Jashdhokiya/miniOsci/oscilloscope_documentation (1).pdf

# STM32F411 Mini Oscilloscope

## with Integrated PWM Function Generator

### Technical Documentation

Firmware Source Code Reference – v1.0

Platform: STM32F411CEU6 (BlackPill) Display: ILI9341 2.8” TFT (SPI) IDE: STM32CubeIDE HAL: STM32F4xx HAL Language: C (ISO C99)
Year: 2026

Project Team

Jash Dhokiya | 23BIT058
Kavisha Sharma | 23BIT067
Dhyeya Choksi | 23BIT055
Tanay Shah | 23BIT062

Pandit Deendayal Energy University Department of ICT / ECE
Embedded Systems Laboratory

Copyright © 2026. Generated documentation. All rights reserved.

## Contents

1 Introduction | 3
2 Hardware Configuration | 5
3 Firmware Architecture | 8
4 Module Reference | 10

STM32F411 Mini Oscilloscope – Technical Documentation | CONTENTS
5 Data Flow and Timing | 16
6 Configuration Reference | 17
7 Build and Flash Instructions | 18
8 Limitations and Future Work | 19
A Interrupt Vector Summary | 20
B Colour Palette | 21
C Glossary | 22

## 1. Introduction

### 1.1 Project Overview

This project implements a dual-channel digital oscilloscope combined with a multi-waveform PWM function generator, running entirely on an STM32F411CEU6 (BlackPill) microcontroller. The system samples two analog input channels using the on-chip 12-bit ADC with DMA, displays real-time waveforms on an ILI9341 TFT LCD over SPI, computes signal parameters (frequency and Vpp), and simultaneously produces a user-selectable waveform on GPIO pin PB8 via PWM with an external RC low-pass filter.
The firmware is structured into well-separated modules: HAL-generated peripheral drivers (ADC, DMA, SPI, TIM, GPIO, USART), and custom application layers for ADC management, signal processing, display rendering, UI/button handling, and function generation.

### 1.2 Feature Summary

Core Features

| Dual-channel ADC input: CH1 (PA0) and CH2 (PA1), 12-bit resolution,
| timer-triggered via TIM2
| DMA transfer: Circular mode on DMA2 Stream 0 – zero CPU overhead for
| sampling
| Configurable time base: Multiple time/division settings via TIM2 auto-
| reload register
| Signal measurements: Real-time frequency (zero-crossing method) and Vpp
| ILI9341 display: Waveform, grid, measurements, and status bar over SPI1
Trigger system: Rising-edge trigger search per acquired buffer
| RUN / HOLD mode: Toggle via push-button (PB0)
| Overall stats overlay: Comprehensive signal statistics (freq, Vpp, Vmin, Vmax,
| Vavg) via push-button (PB4)
| Function generator: Sine, square, triangle, sawtooth – LUT-based PWM
| on PB8 (TIM4 CH3)
Analog watchdog: ADC overvoltage protection (threshold = 3700/4095)

### 1.3 Repository File Map

STM32F411 Mini Oscilloscope – Technical Documentation CHAPTER 1. INTRODUCTION

File | Category | Responsibility
main.c | Application | System init, splash screen, main loop
adc.c | HAL/Peripheral | ADC1 configuration, DMA linkage, GPIO
| | analog pins
dma.c | HAL/Peripheral | DMA2 clock enable, interrupt priority
spi.c | HAL/Peripheral | SPI1 master config for ILI9341
tim.c | HAL/Peripheral | TIM2 (ADC trigger), TIM3 (input capture),
| | TIM4 (PWM), TIM5 (FG step)
gpio.c | HAL/Peripheral | Output pins, button EXTI lines
usart.c | HAL/Peripheral | USART1 (optional debug)
osc adc.c | Application | ADC start/stop, buffer de-interleave, DMA
| | callback
osc signal.c | Application | Frequency, Vpp, trigger, pixel mapping
osc display.c | Application | Grid, waveform, measurement bar rendering
osc ui.c | Application | Button debounce, state machine, index
| | cycling
func gen.c | Application | LUT tables, TIM4/TIM5 PWM function
| | generator
stm32f4xx it.c | ISR | All ISR vectors, EXTI/TIM5/DMA/ADC
| | callbacks
stm32f4xx hal msp.cHAL/Peripheral | MSP init/deinit callbacks
syscalls.c | System | Newlib syscall stubs
sysmem.c | System | Heap memory implementation
system stm32f4xx.c CMSIS | SystemClock and SystemCoreClock init

## 2. Hardware Configuration

### 2.1 Microcontroller

The STM32F411CEU6 (BlackPill) is a Cortex-M4F running at up to 100 MHz. In this project the PLL is configured to deliver exactly 100 MHz system clock from a 25 MHz HSE crystal, enabling deterministic sample rate calculations.

### 2.1.1 System Clock Configuration

1 | RCC_OscInitStruct . OscillatorType = RCC_OSCILLATORTYPE_HSE ;
2 | RCC_OscInitStruct . HSEState | = RCC_HSE_ON ;
3 | RCC_OscInitStruct . PLL . PLLState | = RCC_PLL_ON ;
4 | RCC_OscInitStruct . PLL . PLLSource | = RCC_PLLSOURCE_HSE ;
5 | RCC_OscInitStruct . PLL . PLLM | = 25; | /* divide 25 MHz -> 1 MHz */
6 | RCC_OscInitStruct . PLL . PLLN | = 200; | /* x200 -> 200 MHz VCO | */
7 | RCC_OscInitStruct . PLL . PLLP | = RCC_PLLP_DIV2 ; | /* /2 -> 100 MHz */
8 | RCC_OscInitStruct . PLL . PLLQ | = 4;

Listing 2.1: PLL configuration in SystemClock Config()

fSY SCLK =

fHSE × N
M × P

=

25 × 200
25 × 2

= 100 MHz

### 2.1.2 Bus Clocks

Bus | Divider Frequency
SYSCLK | 1 | 100 MHz
HCLK (AHB) | 1 | 100 MHz
PCLK1 (APB1) 2 | 50 MHz
PCLK2 (APB2) 1 | 100 MHz

Flash Latency

Flash latency is set to FLASH LATENCY 3 (3 wait states) as required for 100 MHz Vcore Scale 1.

### 2.2 GPIO Pin Assignments

STM32F411 Mini Oscilloscope – Technical Documentation CHAPTER 2. HARDWARE CONFIGURATION

Port | Pin | Function | Description
PA0 | – | ADC1 IN0 | Channel 1 analog input
PA1 | – | ADC1 IN1 | Channel 2 analog input
PA3 | – | GPIO Output | ILI9341 DC (Data/Command)
PA4 | – | GPIO Output | ILI9341 CS (Chip Select)
PA5 | – | SPI1 SCK | ILI9341 SPI clock
PA6 | – | TIM3 CH1 | Input capture (reserved/debug)
PA7 | – | SPI1 MOSI | ILI9341 SPI data
PB0 | – | EXTI0 (rising) | Button: RUN/HOLD toggle
PB1 | – | EXTI1 (rising) | Button: Time div cycle
PB2 | – | EXTI2 (rising) | Button: Volt div cycle
PB3 | – | EXTI3 (rising) | Button: Channel toggle
PB4 | – | EXTI4 (rising) | Button: Show overall signal statistics
PB6 | – | GPIO Output | ILI9341 RST
PB7 | – | GPIO Output | ILI9341 LED backlight
PB8 | – | TIM4 CH3 | Function generator PWM output

### 2.3 ADC Configuration

ADC1 is configured in adc.c with the following parameters:

Parameter | Value
Resolution | 12-bit
Clock prescaler | PCLK2 / 4 = 25 MHz ADC clock
Scan mode | Enabled (2 channels)
Conversion mode Discontinuous (timer-triggered)
External trigger | TIM2 TRGO (rising edge)
DMA mode | Circular, half-word
Analog watchdog All regular channels, High = 3700

Both channels are ranked in sequence (Rank 1 = CH0/PA0, Rank 2 = CH1/PA1), with 15 ADC clock cycle sampling time each. The interleaved raw buffer layout is:

adcRawBuffer = [CH1
| | | {z }
0
| | | , CH2 | {z }
| | | 1 , CH1 | {z }
| | | 2 , CH2 | {z }
| | | 3 , . . .]

STM32F411 Mini Oscilloscope – Technical Documentation CHAPTER 2. HARDWARE CONFIGURATION

### 2.4 Timer Summary

Timer | Mode | Period | Purpose
TIM2 | Base +
| TRGO | Runtime
| | variable
(ARR)
| | | ADC sample rate trigger; ARR =
| | | 100 MHz
| | | fs − 1
TIM3 | Input
| Capture | 65535 | CH1 on PA6 (reserved for HW
| | | frequency measurement)
TIM4 | PWM CH3 | FUNCGEN PWM High-frequency carrier for function ARR
| | | generator
TIM5 | Base + IT | fclk
| | fout×64 − 1 | LUT step interrupt for function
| | | generator

## 3. Firmware Architecture

### 3.1 Layer Overview

The firmware follows a layered architecture separating HAL-generated peripheral code

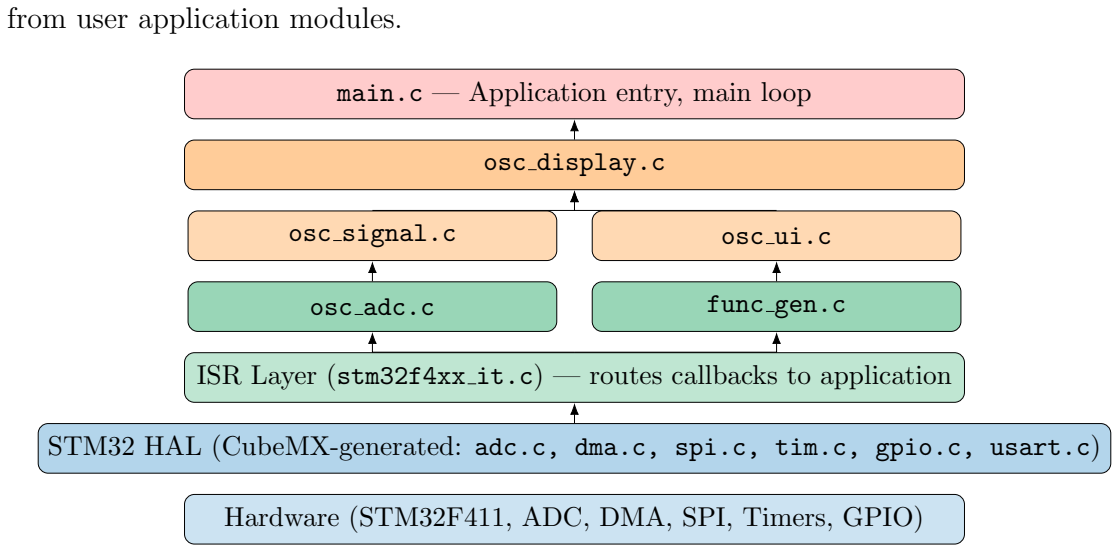
[picture p3: figure]
from user application modules.; osc adc.c; func gen.c; osc signal.c; osc ui.c; osc display.c; main.c — Application entry, main loop

Hardware (STM32F411, ADC, DMA, SPI, Timers, GPIO)

STM32 HAL (CubeMX-generated: adc.c, dma.c, spi.c, tim.c, gpio.c, usart.c)

ISR Layer (stm32f4xx it.c) — routes callbacks to application

### 3.2 Main Loop Logic

After peripheral initialization and the splash screen, main() enters an infinite loop that polls a volatile flag bufferReady (set by the DMA completion ISR) and the UI state machine:

1 | while (1) {
2 | if ( bufferReady && UI_GetState () == STATE_RUN ) {
3 | bufferReady = 0;
4 | uint16_t * buf = OSC_ADC_GetBuffer ( UI_GetChannel () ) ;
5 | float freq = Signal_GetFrequency ( buf , SAMPLE_BUFFER_SIZE ,
| sampleRate ) ;
6 | float vpp | = Signal_GetVpp ( buf , SAMPLE_BUFFER_SIZE ) ;

7
8 | Display_ClearWaveform () ;
9 | Display_DrawGrid () ;
10 | Display_DrawWaveform ( buf , SAMPLE_BUFFER_SIZE , channel , voltDiv ) ;
11 | Display_DrawMeasurements ( freq , vpp , channel , timeDivIdx ,
| voltDivIdx , 0) ;
12 | }
13 | else if ( UI_GetState () == STATE_HOLD ) {

STM32F411 Mini Oscilloscope – Technical Documentation CHAPTER 3. FIRMWARE ARCHITECTURE

14 | /* Redraw measurements once with HOLD label */
15 | }
16 | }

Listing 3.1: Main application loop (simplified from main.c)

Design Note

The main loop is interrupt-driven – it never polls the ADC directly. All sampling is triggered by TIM2 → ADC → DMA. The CPU is only involved when bufferReady = 1 is set from the DMA ISR, making it quasi-event-driven without an RTOS.

### 3.3 Interrupt Priority Table

Interrupt | Preempt | Sub | Function
DMA2 Stream0 | 0 | 0 | ADC DMA transfer
| | | complete
ADC (analog watchdog) | 0 | 0 | Overvoltage stop
TIM5 | 2 | 0 | Function generator LUT
| | | step
EXTI0–EXTI3 | 3 | 0 | Button press handling

## 4. Module Reference

### 4.1 osc adc.c — ADC Application Layer

### 4.1.1 Purpose

Wraps the CubeMX-generated hadc1 and htim2 handles into a clean start/stop API and exposes per-channel sample buffers. It also performs de-interleaving of the raw DMA buffer.

### 4.1.2 Buffers

1 | static uint16_t adcRawBuffer [ ADC_BUFFER_SIZE ]; /* interleaved CH1 ,CH2
| ,... */
2 | static uint16_t ch1Buffer [ SAMPLE_BUFFER_SIZE ];
3 | static uint16_t ch2Buffer [ SAMPLE_BUFFER_SIZE ];
4 | volatile uint8_t bufferReady = 0;

Listing 4.1: Buffer declarations in osc adc.c

ADC BUFFER SIZE = 2 × SAMPLE BUFFER SIZE to hold both channels interleaved.

### 4.1.3 API

Function | Returns | Description
OSC ADC Start() | void | Starts ADC DMA + TIM2
OSC ADC Stop() | void | Stops TIM2 + ADC DMA
OSC ADC GetBuffer(ch) | uint16 t* | Returns pointer to de-interleaved
| | channel buffer
OSC ADC SetSampleRate(arr) void | Dynamically updates TIM2 ARR

### 4.1.4 De-interleave Algorithm

1 | static void DeInterleave ( void ) {
2 | for ( uint16_t i = 0; i < SAMPLE_BUFFER_SIZE ; i ++) {
3 | ch1Buffer [ i ] = adcRawBuffer [ i * 2];
4 | ch2Buffer [ i ] = adcRawBuffer [ i * 2 + 1];
5 | }
6 | }

Listing 4.2: De-interleave routine

STM32F411 Mini Oscilloscope – Technical Documentation CHAPTER 4. MODULE REFERENCE

### 4.1.5 Callbacks

HAL ADC ConvCpltCallback Called by the DMA ISR when the full buffer is transferred. Sets bufferReady = 1.

HAL ADC LevelOutOfWindowCallback Called by the ADC analog watchdog ISR when input exceeds 3700/4095 (≈ 3.0 V). Calls OSC ADC Stop() to protect inputs.

### 4.2 osc signal.c — Signal Processing

### 4.2.1 Purpose

Pure computation module. Takes raw 12-bit ADC buffers and returns physical measurements. No HAL calls.

### 4.2.2 Function Reference

Function | Returns | Description
Signal GetFrequency(buf, size, sr) | float | Frequency via rising zero-crossing
| | count
Signal GetVpp(buf, size) | float | Peak-to-peak voltage in volts
Signal GetVmin(buf, size) | float | Minimum voltage
Signal GetVmax(buf, size) | float | Maximum voltage
Signal GetAvg(buf, size) | float | DC average voltage
Signal FindTriggerPoint(buf,
size, thresh) | uint16 t | Index of first rising edge crossing
| | thresh
Signal MapToPixel(adcVal, voltDiv) | uint16 t | Maps ADC code to display Y pixel

### 4.2.3 Frequency Measurement Algorithm

The frequency is estimated from the number of rising zero-crossings across the buffer. The midpoint threshold is auto-computed from Vmin and Vmax:

1 | uint16_t midpoint = ( vMin + vMax ) / 2;
2 | if (( vMax - vMin ) < 50) return 0.0 f ; | /* signal too weak */

3
4 | for ( uint16_t i = 1; i < size ; i ++) {
5 | if ( buffer [i -1] < midpoint && buffer [ i ] >= midpoint ) {
6 | crossingCount ++;
7 | if ( crossingCount == 1) firstCrossing = i ;
8 | lastCrossing = i ;
9 | }
10 | }
11 | float samplesPerPeriod = ( lastCrossing - firstCrossing ) / ( crossingCount
- 1) ;
12 return ( float ) sampleRate / samplesPerPeriod ;

Listing 4.3: Zero-crossing frequency algorithm

STM32F411 Mini Oscilloscope – Technical Documentation CHAPTER 4. MODULE REFERENCE

### 4.2.4 Voltage Conversion

Vpp =

ADCmax − ADCmin
4095

× VREF × Rdiv

where VREF = 3.3 V and Rdiv is the input voltage divider ratio defined in config.h.

### 4.2.5 Pixel Mapping

ypixel = ycenter −

ADCval − 2048

ADCper div
×

Hwave

Vdivs

Clamped to [W AV E Y OF F SET, W AV E Y OF F SET + W AV E HEIGHT − 1].

### 4.3 osc display.c — Display Rendering

### 4.3.1 Purpose

Manages all ILI9341 rendering: initialization, grid drawing, waveform plotting with vertical line interpolation between samples, and the top/bottom HUD bars.

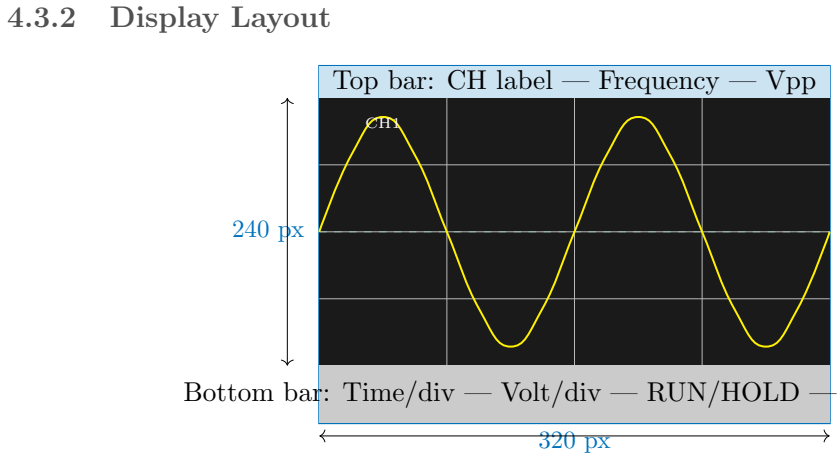
[picture p4: figure]
4.3.2 Display Layout; Top bar: CH label — Frequency — Vpp

Bottom bar: Time/div — Volt/div — RUN/HOLD — FG status

Figure 4.1: ILI9341 display layout (320×240 pixels)

### 4.3.3 API

Function | Returns | Description
Display Init() | void | Init ILI9341, fill black, reset
| | prev-wave state
Display ClearScreen() | void | Fill entire screen black
Display ClearWaveform() | void | Clear waveform region only
Display DrawGrid() | void | Dotted grid + dashed centre
| | axes
Display DrawWaveform(buf,sz,ch,vd) void | Trigger-aligned waveform with
| | line interpolation
Display DrawMeasurements(...) void | Top bar (freq, Vpp), bottom
| | bar (T/div, V/div, mode, FG)

STM32F411 Mini Oscilloscope – Technical Documentation CHAPTER 4. MODULE REFERENCE

Function | Returns | Description
Display ShowWarning(msg) | void | Centred red warning overlay box

### 4.3.4 Waveform Rendering Detail

The waveform is rendered starting from the trigger point (first rising edge). For each sample pair (i−1, i), a pixel and a connecting line are drawn to avoid gaps at low time/div settings:

1 | ILI9341_DrawPixel (x , y , waveColor ) ;
2 | if ( i > 0)
3 | ILI9341_DrawLine ( WAVE_X_OFFSET + i - 1 , prevY , x , y , waveColor ) ;

Listing 4.4: Line interpolation in waveform rendering

### 4.4 osc ui.c — User Interface State Machine

### 4.4.1 State Machine

STATE RUN | STATE HOLD

PB0 pressed

PB0 pressed

PB1/PB2/PB3: div & ch; PB4: stats overlay

Figure 4.2: UI state machine

### 4.4.2 Button Mapping

GPIO Pin | EXTI | Action
PB0 | EXTI0 | Toggle RUN ↔ HOLD; also stops/restarts ADC
PB1 | EXTI1 Cycle time/div index (0 → NUM TIME DIVS −1) + update TIM2 ARR
PB2 | EXTI2 | Cycle volt/div index (0 → NUM VOLT DIVS −1)
PB3 | EXTI3 | Toggle active channel (CH1 ↔ CH2)
PB4 | EXTI4 | Display overall signal statistics overlay (freq, Vpp, Vmin, Vmax, Vavg)

### 4.4.3 Debounce

Software debounce of BUTTON DEBOUNCE MS milliseconds is applied using HAL GetTick() at the start of UI HandleButton().

### 4.5 func gen.c — PWM Function Generator

STM32F411 Mini Oscilloscope – Technical Documentation CHAPTER 4. MODULE REFERENCE

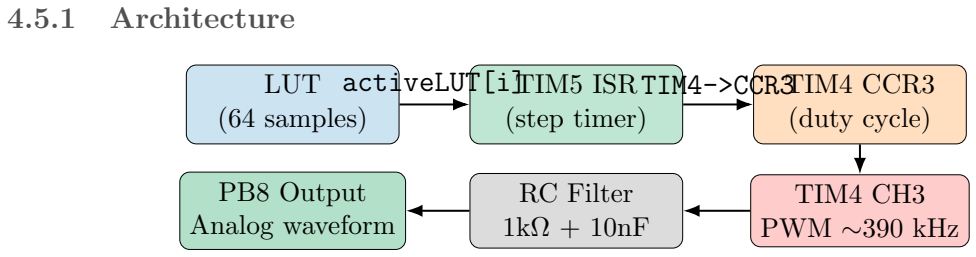
[picture p5: figure]
4.5.1 Architecture; LUT (64 samples); TIM5 ISR (step timer); TIM4 CCR3 (duty cycle); TIM4 CH3 PWM ∼390 kHz; RC Filter 1kΩ + 10nF; PB8 Output Analog waveform; activeLUT[i]; TIM4->CCR3

Figure 4.3: Function generator signal chain

### 4.5.2 Waveform LUTs

Four 64-sample lookup tables are stored in static const uint8 t arrays (values 0–255):

Waveform Table | Description
Sine | sineLUT[64] | Full-period sinusoid
Square | squareLUT[64] | 50% duty, 255 for first 32 samples, 0 for last 32
Triangle | triangleLUT[64] Linear ramp up + down
Sawtooth | sawtoothLUT[64] Linear ramp 0 → 255

### 4.5.3 Frequency Formula

TIM5 auto-reload register (ARR) controls the step rate:

ARRT IM5 =

fclk

fout × NLUT

− 1 =

100 MHz

fout × 64

− 1

fPWMcarrier ≈

fclk
ARRT IM4 + 1

≈ 390 kHz

The RC filter cut-off frequency is:

fc =

1
2πRC =

1
2π × 1000 × 10 × 10⁻⁹

≈ 15.9 kHz

### 4.5.4 ISR – FuncGen StepISR()

Called directly from TIM5 IRQHandler (using raw register access to minimise latency):

1 | void FuncGen_StepISR ( void ) {
2 | TIM4 - > CCR3 = activeLUT [ lutIndex ];
3 | lutIndex = ( lutIndex + 1) & ( FUNCGEN_LUT_SIZE - 1) ;
4 | }

Listing 4.5: LUT step ISR (latency-critical)

The bitmask & 63 wraps the index without a branch.

### 4.5.5 API

STM32F411 Mini Oscilloscope – Technical Documentation CHAPTER 4. MODULE REFERENCE

Function | Returns | Description
FuncGen Init() | void | Sets defaults (sine, 1 kHz), resets
| | state
FuncGen Start() | void | Starts TIM4 PWM + TIM5 step
| | timer
FuncGen Stop() | void | Stops TIM5, zeros duty, stops TIM4
FuncGen SetWaveform(type) | void | Switches active LUT pointer
FuncGen SetFrequency(Hz) | void | Updates TIM5 ARR dynamically
FuncGen IsRunning() | uint8 t | Returns running flag
FuncGen GetFrequency() | uint32 t | Returns current set frequency
FuncGen GetWaveformName() | const
| char* | Returns “SIN”, “SQR”, “TRI”,
| | “SAW”

### 4.6 stm32f4xx it.c — Interrupt Service Routines

### 4.6.1 ISR Routing Table

ISR | Action
SysTick Handler | HAL IncTick() – millisecond tick for HAL
timeouts and debounce
DMA2 Stream0 IRQHandler HAL DMA IRQHandler() → triggers
HAL ADC ConvCpltCallback
ADC IRQHandler | HAL ADC IRQHandler() → analog watchdog
callback
EXTI0...3 IRQHandler HAL GPIO EXTI IRQHandler() →
UI HandleButton(pin)
TIM5 IRQHandler | Direct register: clears UIF, calls
FuncGen StepISR()
HardFault Handler | Infinite loop (breakpoint target)

Why TIM5 bypasses HAL

TIM5 IRQHandler directly clears TIM5->SR and calls FuncGen StepISR() without going through HAL TIM IRQHandler(). This avoids ∼20 HAL overhead instructions, which matters at high function generator frequencies where TIM5 fires at up to fout × 64 times per second.

## 5. Data Flow and Timing

### 5.1 Oscilloscope Data Flow

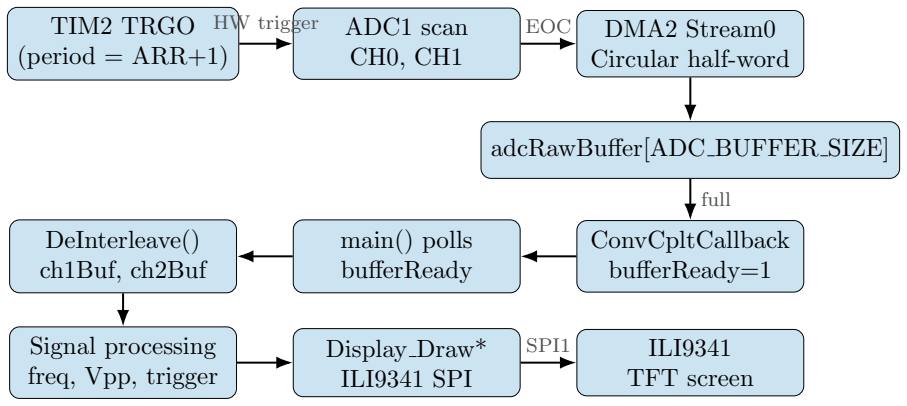
[picture p6: figure]
TIM2 TRGO (period = ARR+1); ADC1 scan CH0, CH1; DMA2 Stream0 Circular half-word; adcRawBuffer[ADC BUFFER SIZE]; ConvCpltCallback bufferReady=1; main() polls bufferReady; DeInterleave() ch1Buf, ch2Buf; Signal processing freq, Vpp, trigger; Display Draw* ILI9341 SPI; ILI9341 TFT screen; HW trigger; EOC; full; SPI1

Figure 5.1: End-to-end oscilloscope data flow

### 5.2 Sample Rate Calculation

TIM2 runs on APB1 ×2 = 100 MHz. The sample rate in samples per second per channel is:

fs =

100 MHz
(ARR + 1) × 2

The factor of 2 accounts for two channels being scanned per TIM2 trigger. The TIME DIV ARR[] lookup table in config.h maps time/div settings to the correct ARR value.

### 5.3 Function Generator Timing

TIM5 fires at fstep = fout × 64. At the default frequency of 1 kHz:

ARRT IM5 =

100 MHz
1000 × 64

− 1 = 1562 − 1 = 1561

The PWM carrier on TIM4 at ≈ 390 kHz combined with the 15.9 kHz RC filter produces a smooth analog approximation of the selected waveform.

## 6. Configuration Reference

All project-wide constants are consolidated in config.h. Key parameters:

Macro | Typical Value | Description
SAMPLE BUFFER SIZE | 512 | Samples per channel per
| | acquisition
ADC BUFFER SIZE | 1024 | Raw DMA buffer (2× above)
ADC MAX | 4095 | 12-bit full-scale
VREF | 3.3f | ADC reference voltage (V)
VOLTAGE DIVIDER RATIO | ≥1.0 | Input resistor divider scale
SCREEN WIDTH | 320 | ILI9341 pixel width
SCREEN HEIGHT | 240 | ILI9341 pixel height
WAVE X OFFSET | – | Left edge of waveform area
WAVE Y OFFSET | – | Top edge of waveform area
WAVE WIDTH | – | Waveform area width
WAVE HEIGHT | – | Waveform area height
GRID DIVISIONS X | 8 | Horizontal grid divisions
GRID DIVISIONS Y | 6 | Vertical grid divisions
NUM TIME DIVS | – | Length of time-div array
NUM VOLT DIVS | – | Length of volt-div array
NUM CHANNELS | 2 | Oscilloscope channels
BUTTON DEBOUNCE MS | 50 | Button debounce time (ms)
FUNCGEN DEFAULT FREQ | 1000 | Default function gen frequency
(Hz)
FUNCGEN LUT SIZE | 64 | Samples per LUT waveform
| | period
FUNCGEN PWM ARR | ≈255 | TIM4 ARR for PWM carrier
FUNCGEN TIM CLOCK | 100000000 | TIM5 clock frequency (Hz)

## 7. Build and Flash Instructions

### 7.1 Prerequisites

| STM32CubeIDE ≥ 1.14 (includes arm-none-eabi-gcc)
| STM32F4xx HAL library (included in CubeIDE)
| ST-Link V2 programmer, or DFU via USB

### 7.2 Project Setup

1. Open STM32CubeIDE and import or create an STM32F411CE project.
2. In CubeMX (inside IDE), configure peripherals to match Chapter 2.
3. Copy all .c files from Src/ into the project’s Core/Src/ folder.
4. Ensure the following driver/library files are present (generated by CubeMX):
| Drivers/STM32F4xx HAL Driver/
| Drivers/CMSIS/
| Core/Inc/ headers: config.h, osc adc.h, osc signal.h,
osc display.h, osc ui.h, func gen.h, ili9341.h
5. Build with Release configuration for optimal performance.
6. Flash via Run → Debug or ST-LINK/V2 programmer.

### 7.3 Expected Boot Sequence

1. HAL, system clock, and all peripherals initialize.
2. Splash screen shown for 1.5 s: “OSCILLOSCOPE / Dual Channel / + Function Generator”.
3. Function generator starts (1 kHz sine on PB8).
4. ADC + DMA + TIM2 start.
5. Main loop begins: waveform acquisition and display.

## 8. Limitations and Future Work

### 8.1 Current Limitations

Known Issues

ADC analog watchdog: Stop on overvoltage does not display a warning in current code – Display ShowWarning() call is commented out in the callback.
| Frequency measurement: Zero-crossing algorithm is susceptible to noise
| on near-DC or irregular signals. No averaging is applied.
| Function generator amplitude: Fixed to 3.3 V swing (PWM × RC). No
| software amplitude control.
| No RTOS: Display latency under heavy SPI loads may cause missed ADC
| buffer cycles (frame dropping, not data loss).

### 8.2 Suggested Improvements

Enhancement Roadmap

Add UART serial output for waveform data export.
| Implement averaging for frequency and Vpp (running mean over N frames).
| Use TIM3 input capture for hardware frequency measurement crosscheck.
Add FreeRTOS task separation between acquisition and rendering.
Implement function generator amplitude control via DAC or digital pot.
Add waveform cursors (time-delta, voltage-delta measurement).
Support FFT spectrum display using CMSIS DSP library.

## A. Interrupt Vector Summary

Vector | Priority (Pre/Sub) Handler
DMA2 Stream0 IRQn | 0 / 0 | HAL DMA IRQHandler
ADC IRQn | 0 / 0 | HAL ADC IRQHandler
TIM5 IRQn | 2 / 0 | FuncGen StepISR (direct)
EXTI0 IRQn | 3 / 0 | UI HandleButton(PIN 0)
EXTI1 IRQn | 3 / 0 | UI HandleButton(PIN 1)
EXTI2 IRQn | 3 / 0 | UI HandleButton(PIN 2)
EXTI3 IRQn | 3 / 0 | UI HandleButton(PIN 3)
EXTI4 IRQn | 3 / 0 | UI HandleButton(PIN 4)
SysTick | – | HAL IncTick

## B. Colour Palette

The display uses the following colour definitions (RGB565 format expected by ILI9341 driver):

Macro | Usage
COLOR BACKGROUND | Screen fill (black)
COLOR GRID | Dotted grid lines
COLOR DARK GREEN | Centre axis lines
COLOR DARK GRAY | Waveform area border
COLOR CH1 | Channel 1 waveform (yellow)
COLOR CH2 | Channel 2 waveform (cyan)
COLOR GREEN | T/div label, RUN indicator
COLOR RED | HOLD indicator, warnings
COLOR ORANGE | Function generator status
COLOR TEXT | General measurement text
COLOR WHITE | Warning overlay text

## C. Glossary

ADC Analog-to-Digital Converter

ARR Auto-Reload Register (sets timer period)

CCR Capture/Compare Register (sets PWM duty cycle)

DMA Direct Memory Access

EXTI External Interrupt line

HAL Hardware Abstraction Layer (STM32 middleware)

HSE High-Speed External crystal oscillator

ILI9341 262K-colour TFT LCD controller by Ilitek

ISR Interrupt Service Routine

LUT Lookup Table

NVIC Nested Vectored Interrupt Controller

PLL Phase-Locked Loop (clock multiplier)

PWM Pulse-Width Modulation

RC filter Resistor-Capacitor low-pass filter

SPI Serial Peripheral Interface

TIM General-Purpose Timer (STM32)

TRGO Timer Trigger Output (used to trigger ADC)

Vpp Peak-to-peak voltage

VREF ADC reference voltage
