Jashdhokiya/miniOsci/Core/Src/main.c

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
/* Includes ------------------------------------------------------------------*/
#include "main.h"
#include "adc.h"
#include "dma.h"
#include "spi.h"
#include "tim.h"
#include "usart.h"
#include "gpio.h"

/* USER CODE BEGIN Includes */
#include "config.h"
#include "osc_adc.h"
#include "osc_signal.h"
#include "osc_display.h"
#include "osc_ui.h"
#include "ili9341.h"
#include "func_gen.h"
#include <string.h>
#include <stdio.h>
/* USER CODE END Includes */


/* USER CODE BEGIN PV */
static uint8_t holdDrawn = 0;
/* USER CODE END PV */

void SystemClock_Config(void);
/**
  * @brief  The application entry point.
  * @retval int
  */
int main(void)
{

  /* MCU Configuration--------------------------------------------------------*/

  /* Reset of all peripherals, Initializes the Flash interface and the Systick. */
  HAL_Init();

  /* Configure the system clock */
  SystemClock_Config();

  /* Initialize all configured peripherals */
  MX_GPIO_Init();
  MX_DMA_Init();
  MX_ADC1_Init();
  MX_SPI1_Init();
  MX_TIM2_Init();
  MX_TIM3_Init();
  MX_USART1_UART_Init();
  MX_TIM4_Init();
  MX_TIM5_Init();
  /* USER CODE BEGIN 2 */

  /* Initialize display */
  Display_Init();

  /* Splash screen — landscape centered */
  ILI9341_FillScreen(COLOR_PANEL_BG);
  ILI9341_DrawString(64, 60, "MINI OSCILLOSCOPE", COLOR_GREEN, COLOR_PANEL_BG, 2);
  ILI9341_DrawString(96, 100, "Dual Channel + FuncGen", COLOR_CYAN, COLOR_PANEL_BG, 1);
  ILI9341_DrawString(88, 130, "STM32F411 BlackPill", COLOR_ORANGE, COLOR_PANEL_BG, 1);
  ILI9341_DrawString(100, 160, "v1.0  |  MiniOsci", COLOR_AXIS_LABEL, COLOR_PANEL_BG, 1);
  HAL_Delay(1500);
  Display_ClearScreen();

  /* Start function generator (1 kHz sine on PB8) */
  FuncGen_Init();
  FuncGen_Start();

  /* Start ADC + DMA + Timer sampling */
  OSC_ADC_Start();

  /* USER CODE END 2 */

  /* Infinite loop */
  /* USER CODE BEGIN WHILE */
  while (1)
  {
    /* USER CODE END WHILE */

    /* USER CODE BEGIN 3 */

    /* === Oscilloscope Main Loop === */
    if (bufferReady && UI_GetState() == STATE_RUN)
    {
        bufferReady = 0;

        uint8_t ch        = UI_GetChannel();
        uint16_t* buf     = OSC_ADC_GetBuffer(ch);
        float voltDiv     = UI_GetVoltDiv();
        uint8_t timeDivIdx  = UI_GetTimeDivIndex();
        uint8_t voltDivIdx  = UI_GetVoltDivIndex();

        uint32_t sampleRate = 100000000UL / (TIME_DIV_ARR[timeDivIdx] + 1);
        float freq = Signal_GetFrequency(buf, SAMPLE_BUFFER_SIZE, sampleRate);
        float vpp  = Signal_GetVpp(buf, SAMPLE_BUFFER_SIZE);

        static uint8_t lastStatsVisible = 0;

        /* If stats overlay was just turned off, full-clear once to wipe it */
        if (lastStatsVisible && !UI_GetStatsVisible()) {
            Display_ClearWaveform();
        }
        lastStatsVisible = UI_GetStatsVisible();

        /* Grid: draw once, then only repaired internally by DrawWaveform.
           Automatically redrawn if ClearWaveform was called above. */
        if (Display_NeedsGrid()) {
            Display_DrawGrid();
        }

        /* Axis labels: only redrawn internally when voltDiv changes */
        Display_DrawAxisLabels(timeDivIdx, voltDivIdx);

        /* Waveform: self-erasing + grid repair */
        Display_DrawWaveform(buf, SAMPLE_BUFFER_SIZE, ch, voltDiv);

        /* Measurements: only redrawn internally when values change */
        Display_DrawMeasurements(freq, vpp, ch, timeDivIdx, voltDivIdx, 0);

        /* Stats overlay (toggle with PB4) */
        if (UI_GetStatsVisible()) {
            Display_DrawStats(buf, SAMPLE_BUFFER_SIZE, ch);
        }
    }
    else if (UI_GetState() == STATE_HOLD)
    {
        /* Redraw HOLD status once */
        if (!holdDrawn) {
            uint8_t ch = UI_GetChannel();
            uint16_t* buf = OSC_ADC_GetBuffer(ch);
            uint8_t tdi = UI_GetTimeDivIndex();
            uint8_t vdi = UI_GetVoltDivIndex();
            uint32_t sr = 100000000UL / (TIME_DIV_ARR[tdi] + 1);
            float f = Signal_GetFrequency(buf, SAMPLE_BUFFER_SIZE, sr);
            float v = Signal_GetVpp(buf, SAMPLE_BUFFER_SIZE);
            Display_DrawMeasurements(f, v, ch, tdi, vdi, 1);
            holdDrawn = 1;
        }
    }
    else
    {
        holdDrawn = 0;
    }

  }
  /* USER CODE END 3 */
}

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
