Jashdhokiya/miniOsci/MiniOsci.ioc

Mcu.UserName=STM32F411CEUx
PA0-WKUP.Signal=ADCx_IN0
PA1.Signal=ADCx_IN1
PA10.Signal=USART1_RX
PA3.Signal=GPIO_Output
PA4.Signal=GPIO_Output
PA5.Signal=SPI1_SCK
PA6.Signal=S_TIM3_CH1
PA7.Signal=SPI1_MOSI
PA9.Signal=USART1_TX
PB0.Signal=GPXTI0
PB1.Signal=GPXTI1
PB2.Signal=GPXTI2
PB3.Signal=GPXTI3
PB6.Signal=GPIO_Output
PB7.Signal=GPIO_Output
PB8.Signal=S_TIM4_CH3
